upenn-embedded/final-project-website-submission-f25-t30-f25-int-main-void/images/HRS03_humidity.jpg

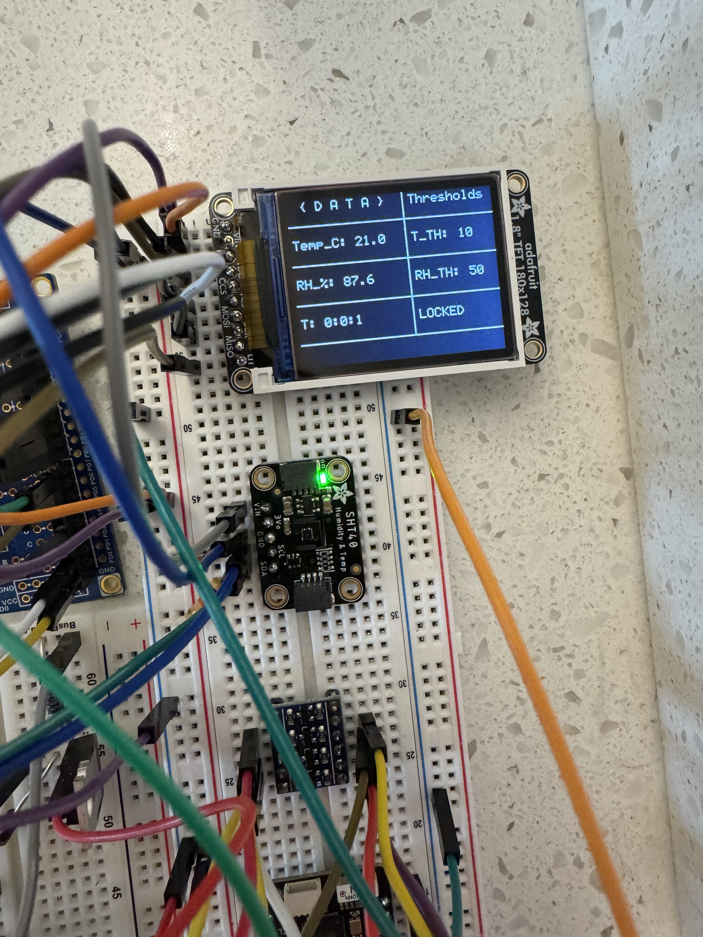
images/HRS03_humidity.jpg
