upenn-embedded/final-project-website-submission-f25-t30-f25-int-main-void/code/mcu1/LCD_GFX.c

/*
 * LCD_GFX.c
 *
 * Created: 9/20/2021 6:54:25 PM
 *  Author: You
 */ 

#include "LCD_GFX.h"
#include "ST7735.h"
#include <math.h>

#define X_LEN 160
#define Y_LEN 128

/******************************************************************************
* Local Functions
******************************************************************************/



/******************************************************************************
* Global Functions
******************************************************************************/

/**************************************************************************//**
* @fn			uint16_t rgb565(uint8_t red, uint8_t green, uint8_t blue)
* @brief		Convert RGB888 value to RGB565 16-bit color data
* @note
*****************************************************************************/
uint16_t rgb565(uint8_t red, uint8_t green, uint8_t blue)
{
	return ((((31*(red+4))/255)<<11) | (((63*(green+2))/255)<<5) | ((31*(blue+4))/255));
}

/**************************************************************************//**
* @fn			void LCD_drawPixel(uint8_t x, uint8_t y, uint16_t color)
* @brief		Draw a single pixel of 16-bit rgb565 color to the x & y coordinate
* @note
*****************************************************************************/
void LCD_drawPixel(uint8_t x, uint8_t y, uint16_t color) {
	LCD_setAddr(x,y,x,y);
	SPI_ControllerTx_16bit(color);
}

/**************************************************************************//**
* @fn			void LCD_drawChar(uint8_t x, uint8_t y, uint16_t character, uint16_t fColor, uint16_t bColor)
* @brief		Draw a character starting at the point with foreground and background colors
* @note
*****************************************************************************/
void LCD_drawChar(uint8_t x, uint8_t y, uint16_t character, uint16_t fColor, uint16_t bColor){
	uint16_t row = character - 0x20;		//Determine row of ASCII table starting at space
	int i, j;
	if ((LCD_WIDTH-x>7)&&(LCD_HEIGHT-y>7)){
		for(i=0;i<5;i++){
			uint8_t pixels = ASCII[row][i]; //Go through the list of pixels
			for(j=0;j<8;j++){
				if ((pixels>>j)&1==1){
					LCD_drawPixel(x+i,y+j,fColor);
				}
				else {
					LCD_drawPixel(x+i,y+j,bColor);
				}
			}
		}
	}
}


/******************************************************************************
* LAB 4 TO DO. COMPLETE THE FUNCTIONS BELOW.
* You are free to create and add any additional files, libraries, and/or
*  helper function. All code must be authentically yours.
******************************************************************************/

/**************************************************************************//**
* @fn			void LCD_drawLine(short x0,short y0,short x1,short y1,uint16_t c)
* @brief		Draw a line from and to a point with a color
* @note
*****************************************************************************/
void LCD_drawLine(short x0,short y0,short x1,short y1,uint16_t c)
{
	// Fill this out
    float gradient = (float) (y1 - y0) / (x1 - x0);
    int delta_y = 0;
    if (x0<x1) // x0<x1 increment
    {
        for(uint8_t x=x0; x<=x1; x++)
        {
            delta_y = (int) round(gradient * (x - x0)); // round delta y
            LCD_drawPixel(x, y0 + delta_y, c);
        }
    }
    else if(x0>x1)// x0>x1 decrement
    {
        for(uint8_t x=x0; x>=x1; x--)
        {
            delta_y = (int) round(gradient * (x - x0)); // round delta y
            LCD_drawPixel(x, y0 + delta_y, c);
        }
    }
    else // x0=x1
    {  
        if (y0<=y1) // x0<x1 increment
    {
        for(uint8_t y=y0; y<=y1; y++)
        {
            LCD_drawPixel(x0, y, c);
        }
    }
    else if(y0>y1)// x0>x1 decrement
    {
        for(uint8_t y=y0; y>=y1; y--)
        {

            LCD_drawPixel(x0, y, c);
        }
    }
    }
}

/**************************************************************************//**
* @fn			void LCD_setScreen(uint16_t color)
* @brief		Draw the entire screen to a color
* @note
*****************************************************************************/
void LCD_setScreen(uint16_t color) 
{
	// Fill this out
    // draw every pixel
    for(uint8_t j=0; j<Y_LEN; j++)
    {
		for(uint8_t i=0; i<X_LEN; i++)
        {
			LCD_drawPixel(i, j, color);
		}
	}
}

/**************************************************************************//**
* @fn			void LCD_drawString(uint8_t x, uint8_t y, char* str, uint16_t fg, uint16_t bg)
* @brief		Draw a string starting at the point with foreground and background colors
* @note
*****************************************************************************/
void LCD_drawString(uint8_t x, uint8_t y, char* str, uint16_t fg, uint16_t bg)
{
	// Fill this out
    // one character, 6x8. x: 6 pixel, y: 8 pixel
    for (uint8_t i=0; str[i]!='\0'; i++)
    {
        LCD_drawChar(x + i * 6, y, str[i], fg, bg);
    }
}
