upenn-embedded/final-project-website-submission-f25-t30-f25-int-main-void/images/sprint2_screen.jpg

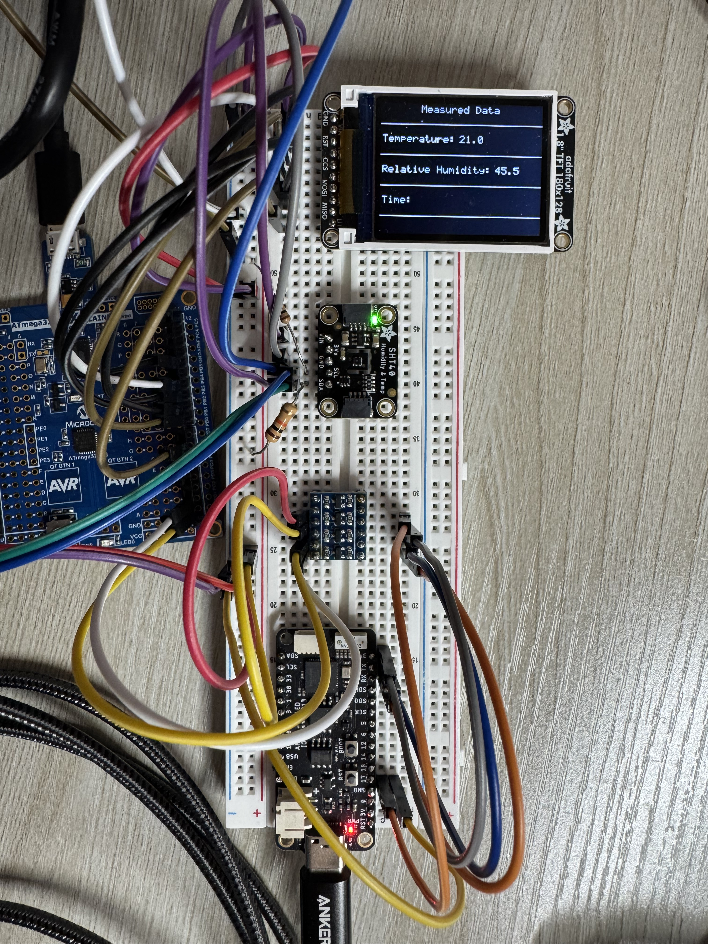
[picture p9: images/sprint2_screen.jpg]
images/sprint2_screen.jpg
