upenn-embedded/final-project-website-submission-f25-t30-f25-int-main-void/images/sprint2_battery.jpg

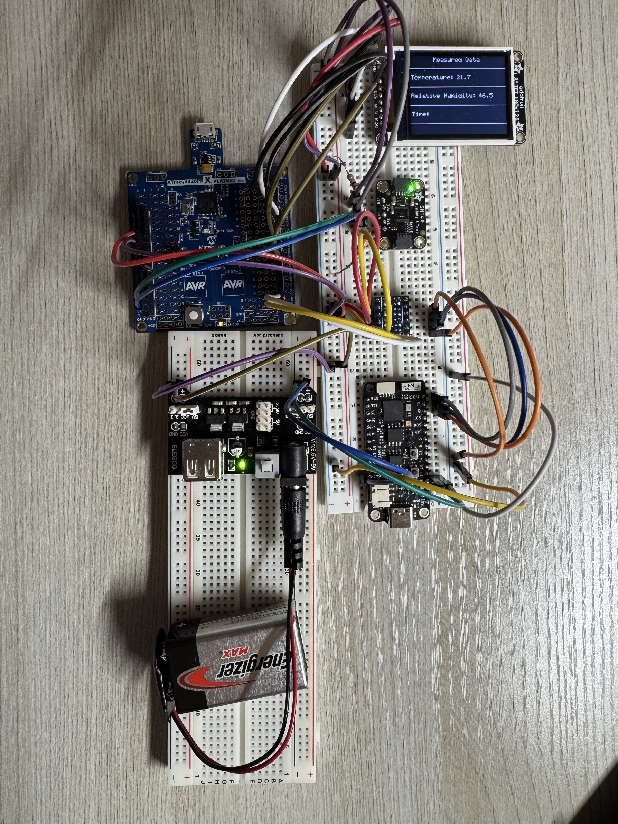
[picture p28: images/sprint2_battery.jpg]
images/sprint2_battery.jpg
